Go-Baby-Go/Go-Baby-Go/README.md

# Go-Baby-Go
<h1 align="center">
  <a href="http://www.amitmerchant.com/electron-markdownify">Markdownify</a>
</h1>

<h4 align="center">An open-source project allowing children with physical disabilities to move freely and independently during recess</a>.</h4>
 
<p align="center">
  <a href="#key-features">Key Features</a> •
  <a href="#how-to-use">How To Use</a> •
  <a href="#credits">Credits</a> •
  <a href="#license">License</a>
</p>

## Key Features

* For children 40 ± 10 lbs, 40” ± 5”
* Control Methods
  - Joy-Stick Power Steering
* Chair and User Support
* Table Attachment
* Code and Control Sensitivity
  - Open-source code allows users to customize control for individual needs
* All-Terrain Wheels and Kickstand
* Battery and Electronics
  - Remote Shutoff up to 35ft

## How To Use

Upon building the system using the Bill of Materials and User Manual, download the [ELEGOO Driver V3.0](https://www.elegoo.com/blogs/arduino-projects/elegoo-arduino-nano-board-ch340-usb-driver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). Clone this [repository](https://github.com/misamonique/Go-Baby-Go/blob/main/gobabygo_s21_final.ino) and run the code through Arduino software into the connected Go-Baby-Go system.

## Credits

- Readme page format by [amitmerchant1990](https://user-images.githubusercontent.com/82772693/166486935-7875a53a-c760-4e75-9e84-1c67b53c1776.png)

## License

Colorado School of Mines
